dotti-ba/diyBMSv4/Circuit/v4.png

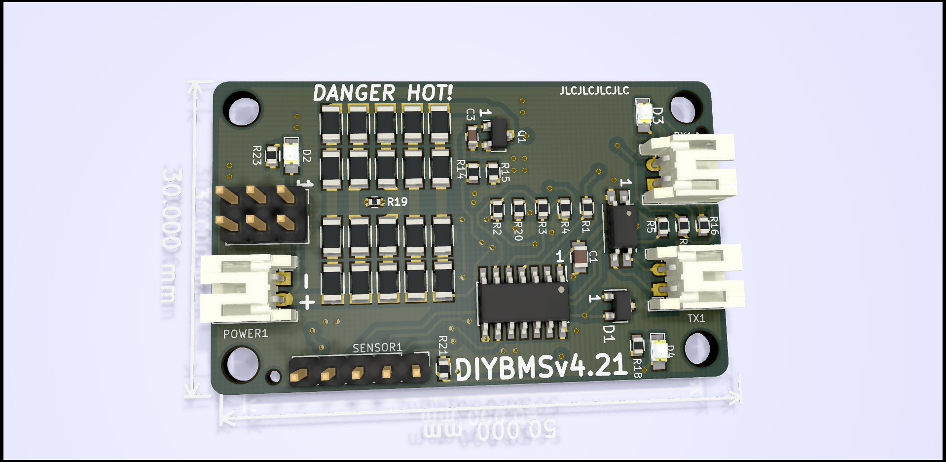
Circuit/v4.png
