dotti-ba/diyBMSv4/ESPControllerCircuit/ESPControllerCircuit_bom_jlc.csv

Comment | Designator | Footprint | LCSC Part #
COMMS | D1 | LED_0805 | C2297
470R | R1 | R_0805_HandSoldering | C17710
4K7 | R4,R5 | R_0805_HandSoldering | C17673
2K2 | R2 | R_0805_HandSoldering | C17520
220R | R3 | R_0805_HandSoldering | C17557
EL3H7(B)(TA)-G | U2 | SOP-4_4.4x2.8mm_Pitch1.27mm | C32565
PCF8574T/3,518 | U3 | SOIC-16W_7.5x10.3mm_Pitch1.27mm | C7605
