dotti-ba/diyBMSv4/ESPControllerCircuit/ESPControllerCircuit.pdf

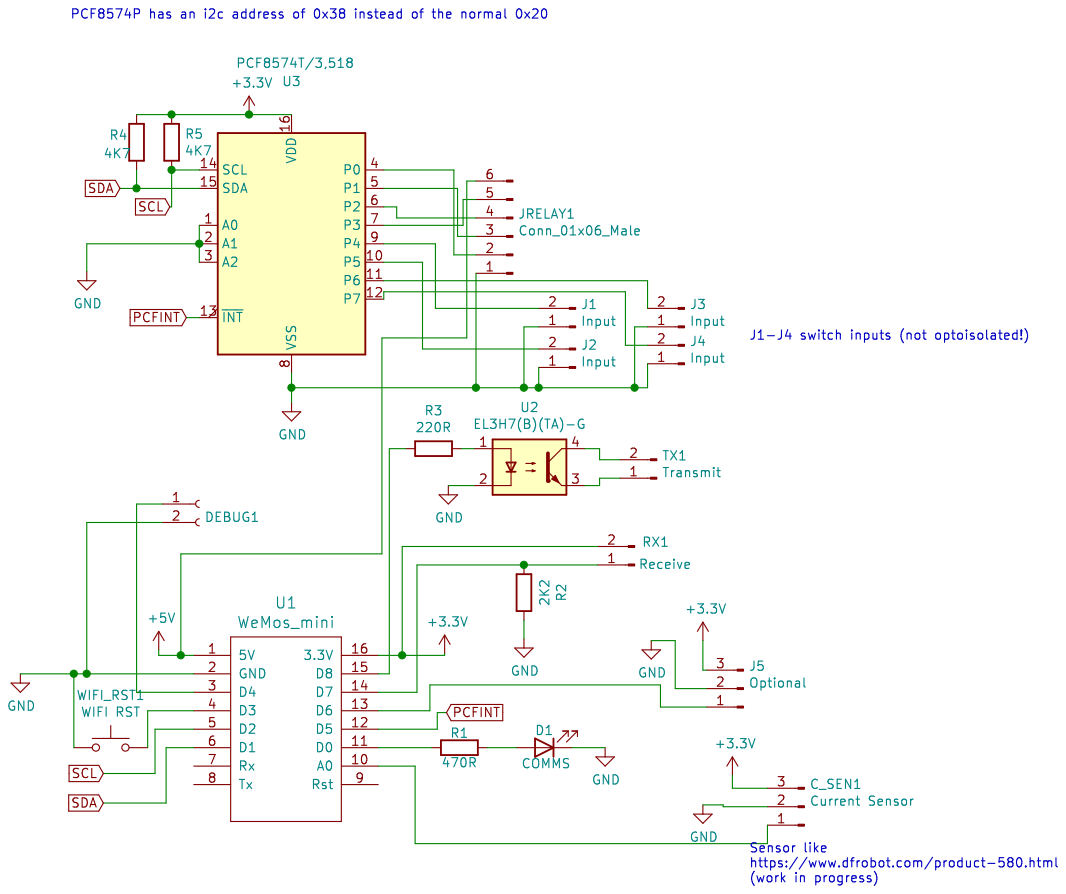
[picture p2: page 1]
