dotti-ba/diyBMSv4/Circuit/circuit.pdf

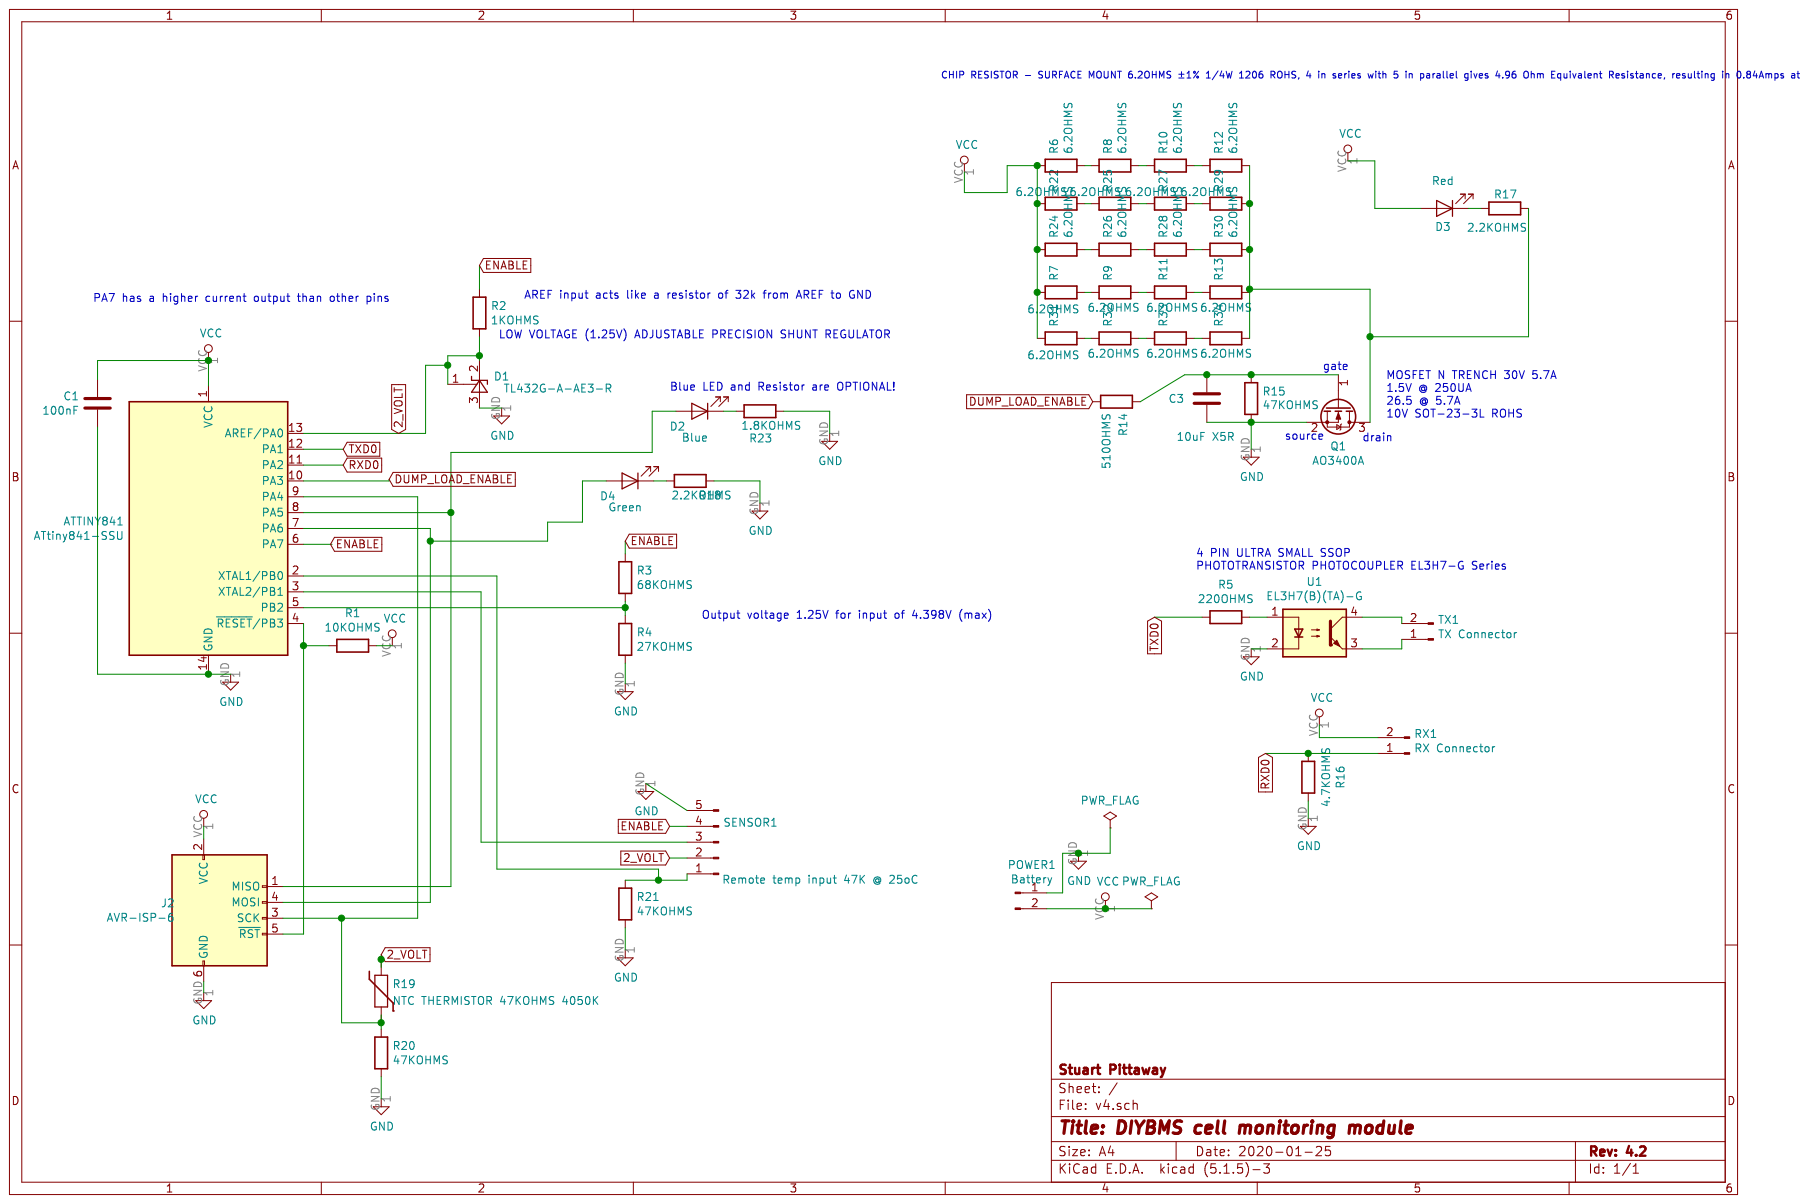
[picture p3: page 1]
