dotti-ba/diyBMSv4/ESPControllerCircuit/ESPControllerCircuit.kicad_pcb

## KiCad design ESPControllerCircuit/ESPControllerCircuit.kicad_pcb (2020-07-24)

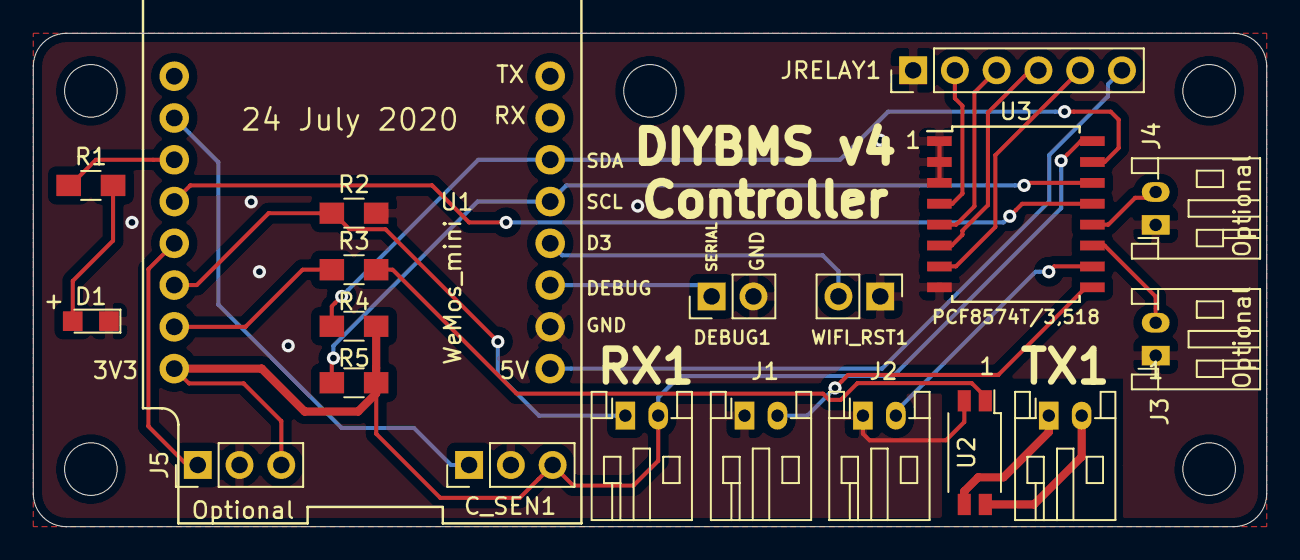
[picture p4: board ESPControllerCircuit.kicad_pcb from above]

Board: 2 copper layers, 75.0 x 30.0 mm, 20 parts (0 on the bottom side), 25 nets.

Parts:
C_SEN1: Current Sensor; Pin_Header_Straight_1x03_Pitch2.54mm
D1: COMMS; LED_0805
DEBUG1: Conn_01x02_Female; Pin_Header_Straight_1x02_Pitch2.54mm
J1, J2, J3, J4: Input; JST_PH_S2B-PH-K_02x2.00mm_Angled
J5: Optional; Pin_Header_Straight_1x03_Pitch2.54mm
JRELAY1: Conn_01x06_Male; Pin_Header_Straight_1x06_Pitch2.54mm
R1: 470R; R_0805_HandSoldering
R2, R4, R5: 4K7; R_0805_HandSoldering
R3: 220R; R_0805_HandSoldering
RX1: Receive; JST_PH_S2B-PH-K_02x2.00mm_Angled
TX1: Transmit; JST_PH_S2B-PH-K_02x2.00mm_Angled
U1: WeMos_mini; wemos-d1-mini-with-pin-header
U2: EL3H7(B)(TA)-G; SOP-4_4.4x2.8mm_Pitch1.27mm
U3: PCF8574T/3,518; SOIC-16W_7.5x10.3mm_Pitch1.27mm
WIFI_RST1: WIFI RST; Pin_Header_Straight_1x02_Pitch2.54mm

Connections:
+3V3: C_SEN1.3, J5.3, R4.1, R5.1, RX1.2, U1.16, U3.16
+5V: JRELAY1.6, U1.1
GND: C_SEN1.2, D1.1, DEBUG1.2, J1.1, J2.1, J3.1, J4.1, J5.2, JRELAY1.1, R2.1, U1.2, U2.2, U3.1, U3.2, U3.3, U3.8, WIFI_RST1.1
unnamed: C_SEN1.1, U1.10
unnamed: D1.2, R1.1
unnamed: DEBUG1.1, U1.3
unnamed: J1.2, U3.9
unnamed: J2.2, U3.10
unnamed: J3.2, U3.11
unnamed: J4.2, U3.12
unnamed: J5.1, U1.13
unnamed: JRELAY1.2, U3.4
unnamed: JRELAY1.3, U3.5
unnamed: JRELAY1.4, U3.6
unnamed: JRELAY1.5, U3.7
unnamed: R1.2, U1.11
unnamed: R2.2, RX1.1, U1.14
unnamed: R3.1, U2.1
unnamed: R3.2, U1.15
unnamed: TX1.1, U2.3
unnamed: TX1.2, U2.4
unnamed: U1.4, WIFI_RST1.2
PCFINT: U1.12, U3.13
SCL: R5.2, U1.5, U3.14
SDA: R4.2, U1.6, U3.15
