dotti-ba/diyBMSv4/(commit log)

2020-04-19 Change 1.25V reference from AZ432A to TL432G
    As recommended by GeorgeBoudreau, change diode to part which is not EOL
    [v4.csv, v4.sch, v4_bom_jlc.csv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]
2020-04-29 Rotated R23
    [v4_cpl_jlc.csv]
2020-04-29 Update thermistor to NCP15WB473F03RC
    [ESPControllerCircuit-B_Cu.gbr, ESPControllerCircuit-B_Mask.gbr, ESPControllerCircuit-B_Paste.gbr, ESPControllerCircuit-B_SilkS.gbr, ESPControllerCircuit-Edge_Cuts.gbr, ESPControllerCircuit-F_Cu.gbr, ESPControllerCircuit-F_Mask.gbr, ESPControllerCircuit-F_Paste.gbr]
2020-04-29 Added JLCPCB assembly mounting holes
    [v4-B_Adhes.gbr, v4-B_Cu.gbr, v4-B_Mask.gbr, v4-B_Paste.gbr, v4-B_SilkS.gbr, v4-Edge_Cuts.gbr, v4-F_Adhes.gbr, v4-F_Cu.gbr]
2020-05-13 Rotate ATTINY841 270 degrees
    [v4_cpl_jlc.csv]
2020-07-09 Added + symbol near diodes to aid construction
    [v4.kicad_pcb]
2020-07-09 Updated Gerber after silkscreen change
    [v4-B_Adhes.gbr, v4-B_Cu.gbr, v4-B_Mask.gbr, v4-B_Paste.gbr, v4-B_SilkS.gbr, v4-Edge_Cuts.gbr, v4-F_Adhes.gbr, v4-F_Cu.gbr]
2020-07-24 Fix for issue #44
    Enlarge footprint for PCF8574 to SOIC16-Wide
    Swap LED to surface mount
    [ESPControllerCircuit-B_Cu.gbr, ESPControllerCircuit-B_Mask.gbr, ESPControllerCircuit-B_Paste.gbr, ESPControllerCircuit-B_SilkS.gbr, ESPControllerCircuit-Edge_Cuts.gbr, ESPControllerCircuit-F_Cu.gbr, ESPControllerCircuit-F_Mask.gbr, ESPControllerCircuit-F_Paste.gbr]
2020-07-24 Updated BOM
    [ESPControllerCircuit.csv, ESPControllerCircuit_bom_jlc.csv]
2020-09-11 Updated Gerbers
    [ESPControllerCircuit-B_Cu.gbr, ESPControllerCircuit-B_Mask.gbr, ESPControllerCircuit-B_Paste.gbr, ESPControllerCircuit-B_SilkS.gbr, ESPControllerCircuit-Edge_Cuts.gbr, ESPControllerCircuit-F_Cu.gbr, ESPControllerCircuit-F_Mask.gbr, ESPControllerCircuit-F_Paste.gbr]
2020-12-27 BOM change for TL432 to C171428
    [v4_bom_jlc.csv]
2020-12-27 Update v4_cpl_jlc.csv
    Update to reflect changes in BOM
    [v4_cpl_jlc.csv]
2021-01-11 Update v4_bom_jlc.csv
    Changed TL432 (again) to C126100 HTC Korea TAEJIN Tech TL432CSF
    [v4_bom_jlc.csv]
2021-01-16 Changed R2 to 2k2 from 4k7 to improve comms in noisy conditions
    [ESPControllerCircuit.sch, ESPControllerCircuit_bom_jlc.csv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]
2021-01-30 Change part number on D1 to TL432CSF
    [v4.sch]
