dotti-ba/diyBMSv4/(notices)

Notices in the files:
ESPControllerCircuit/ESPControllerCircuit.kicad_pcb:
©2019/2020 Stuart Pittaway
